tactilearena/tactilearena.github.io/docs/assets/figures/overview.jpg

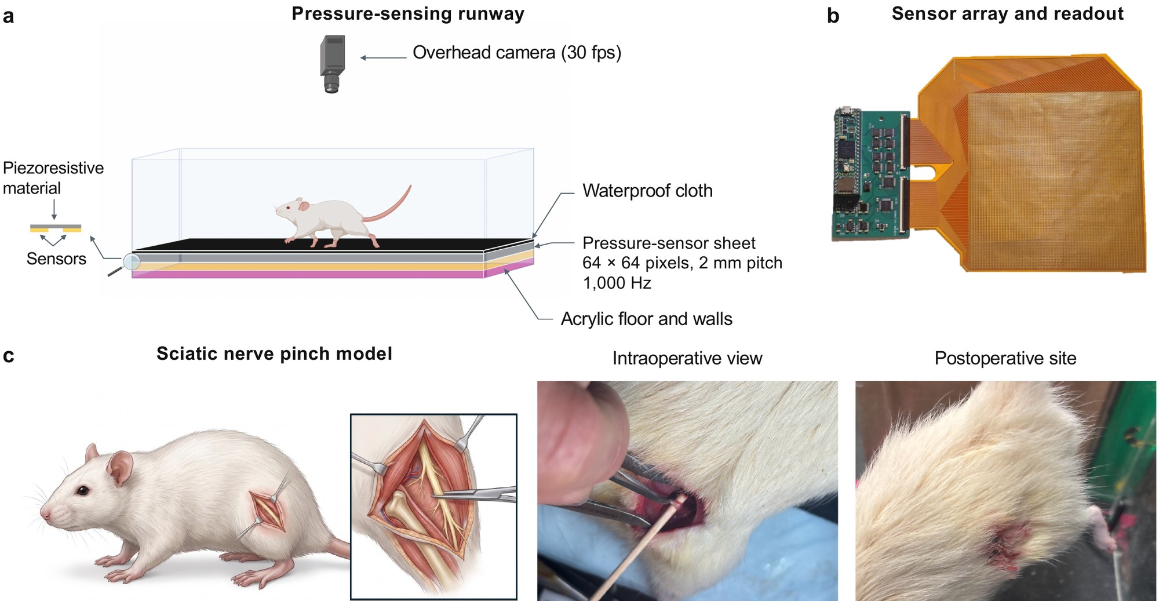
docs/assets/figures/overview.jpg
