tactilearena/tactilearena.github.io/docs/assets/loops/camera_floor.jpg

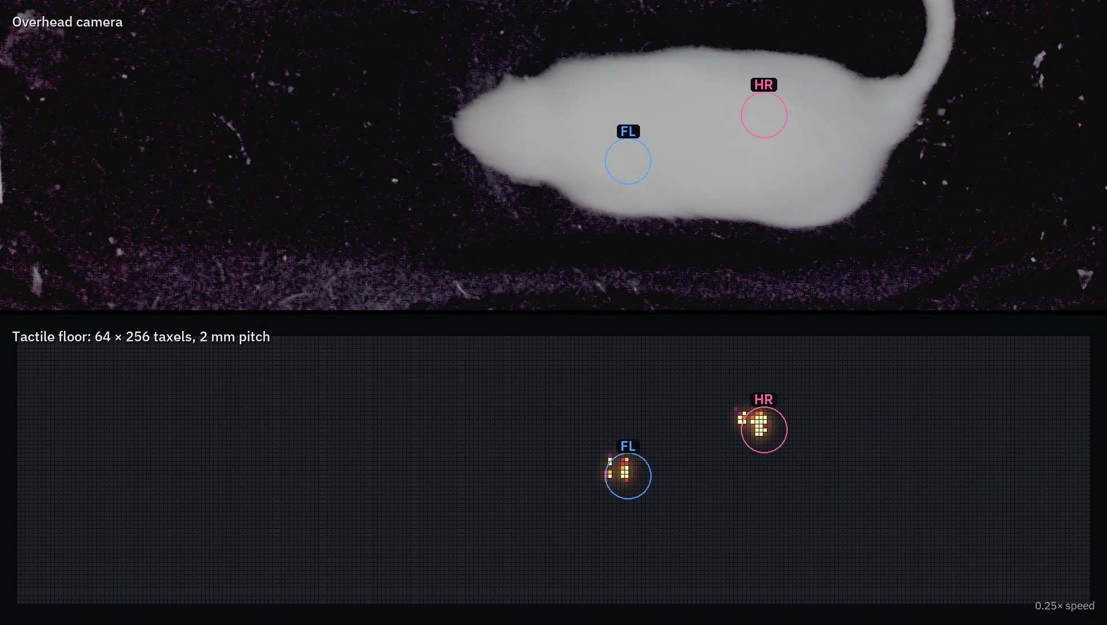
docs/assets/loops/camera_floor.jpg
