tactilearena/tactilearena.github.io/docs/assets/loops/hero.jpg

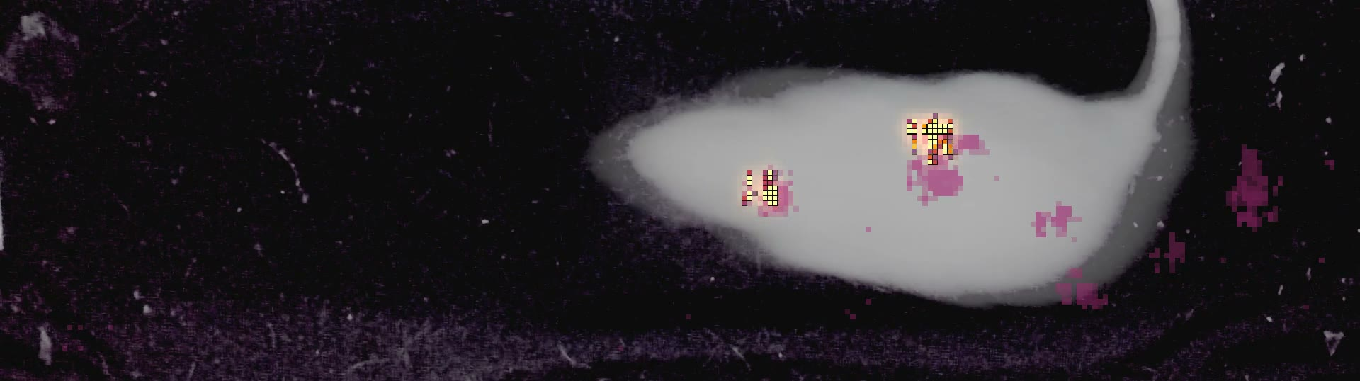
docs/assets/loops/hero.jpg
