tactilearena/tactilearena.github.io/docs/assets/loops/sampling.jpg

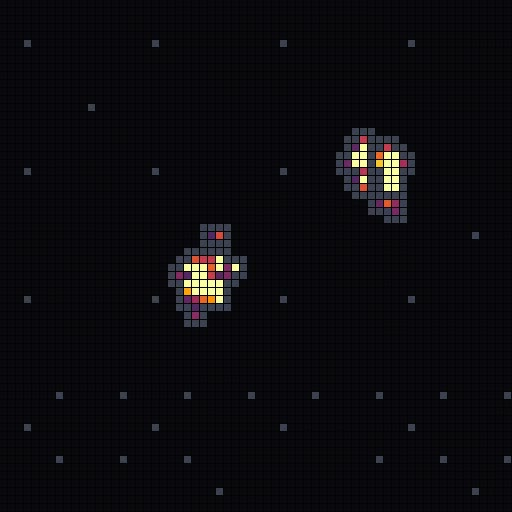
docs/assets/loops/sampling.jpg
