tactilearena/tactilearena.github.io/docs/assets/photos/readout_board.jpg

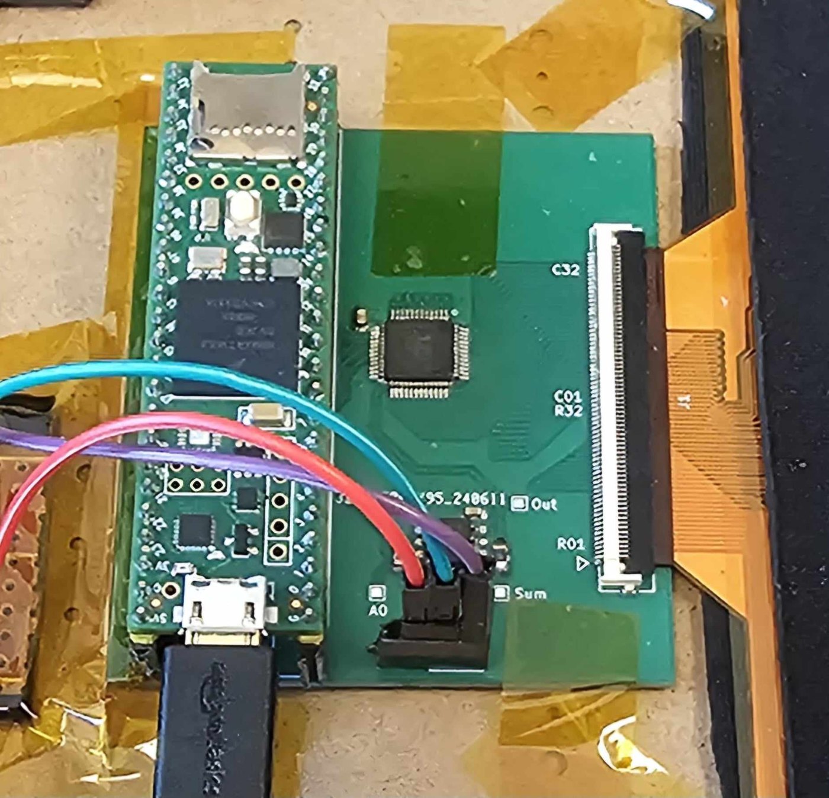
docs/assets/photos/readout_board.jpg
