tactilearena/tactilearena.github.io/docs/assets/photos/runway_rat.jpg

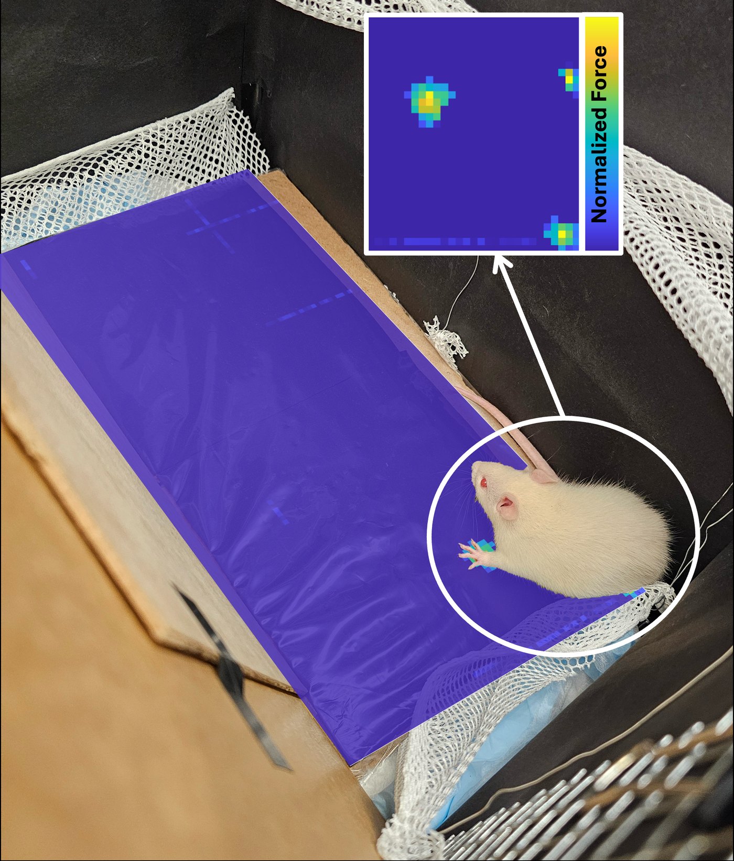
docs/assets/photos/runway_rat.jpg
