tactilearena/tactilearena.github.io/docs/assets/photos/runway_rat_raw.jpg

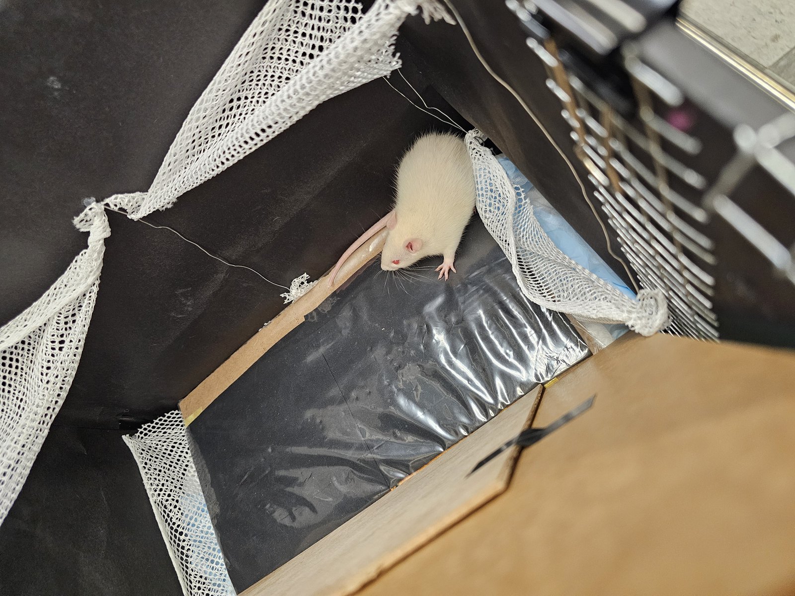
docs/assets/photos/runway_rat_raw.jpg
