tactilearena/tactilearena.github.io/docs/assets/photos/sensor_array.jpg

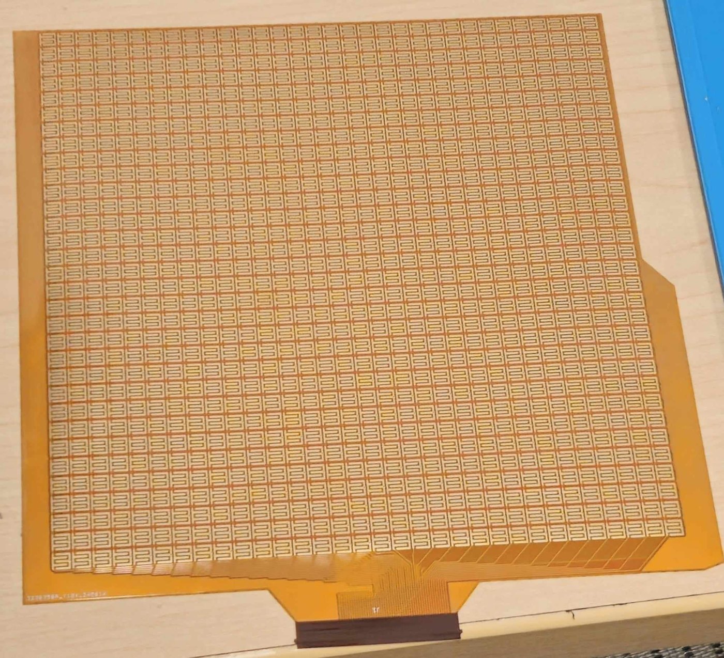
docs/assets/photos/sensor_array.jpg
