tactilearena/tactilearena.github.io/docs/assets/video/arena_bench.jpg

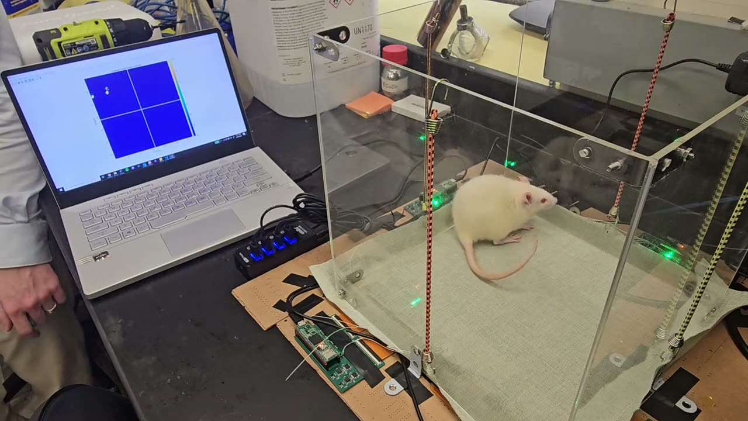
docs/assets/video/arena_bench.jpg
