tactilearena/tactilearena.github.io/docs/assets/video/arena_multi.jpg

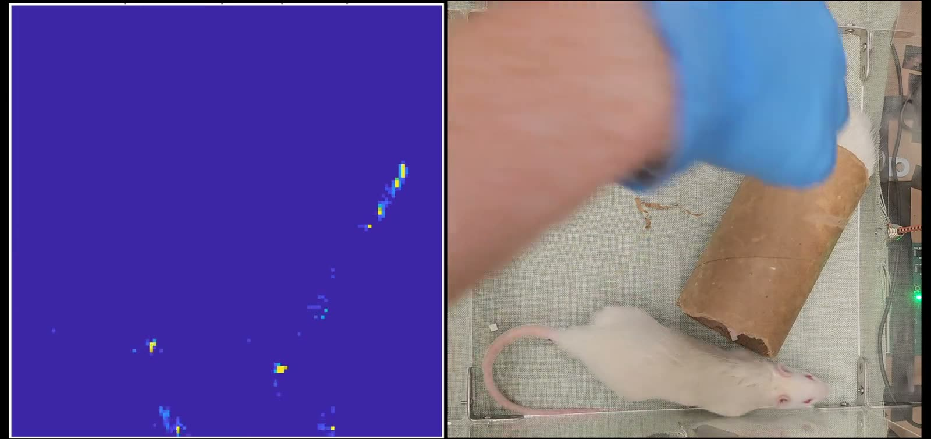
docs/assets/video/arena_multi.jpg
