tactilearena/tactilearena.github.io/docs/assets/video/overview.jpg

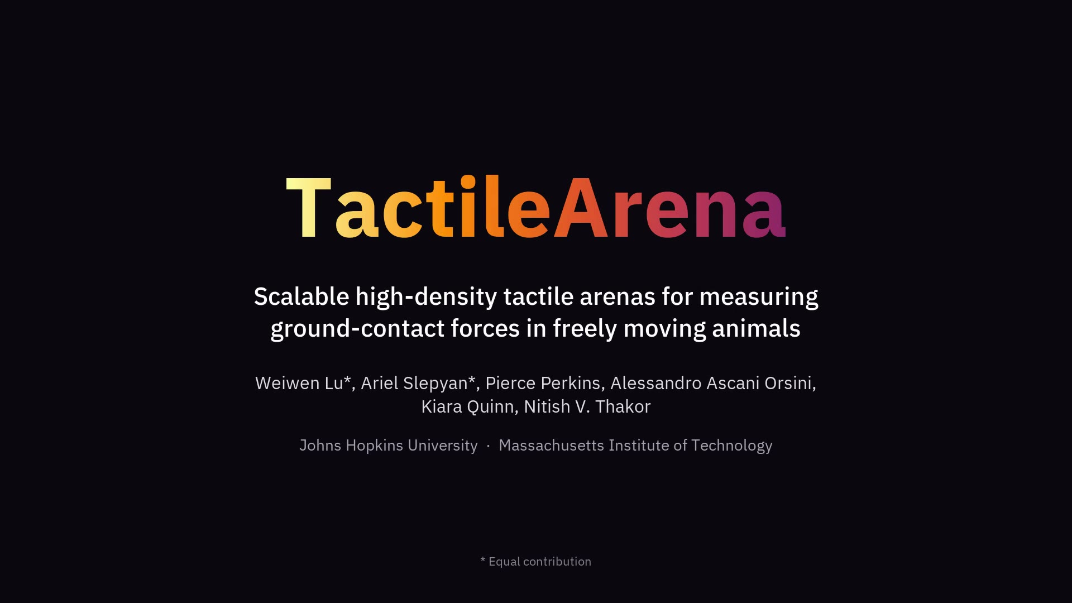
docs/assets/video/overview.jpg
