tactilearena/tactilearena.github.io/docs/assets/video/post-surgery.jpg

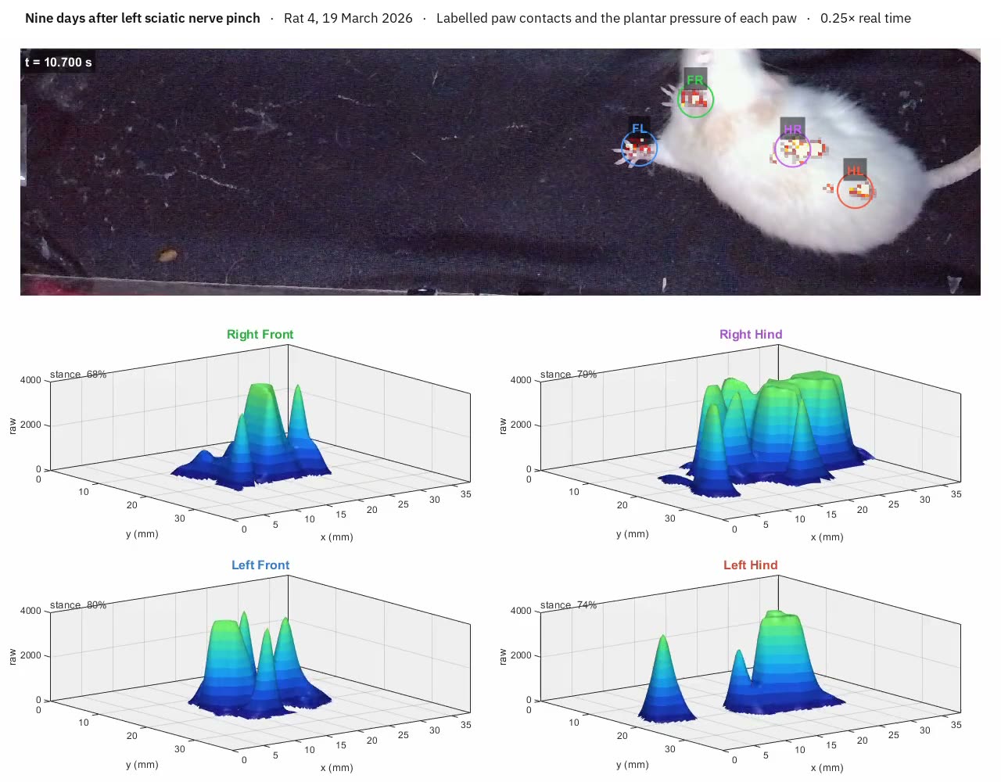
docs/assets/video/post-surgery.jpg
