tactilearena/tactilearena.github.io/docs/assets/video/pre-surgery.jpg

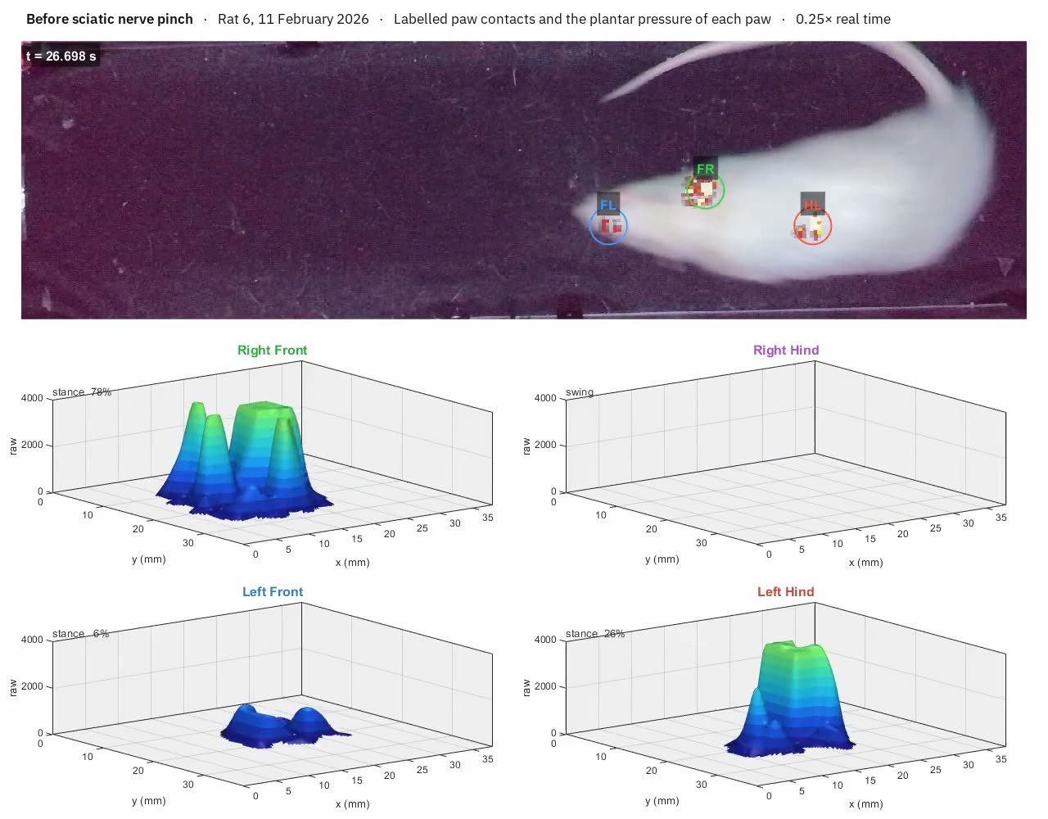
docs/assets/video/pre-surgery.jpg
