tactilearena/tactilearena.github.io/docs/assets/video/supp4_sampling.jpg

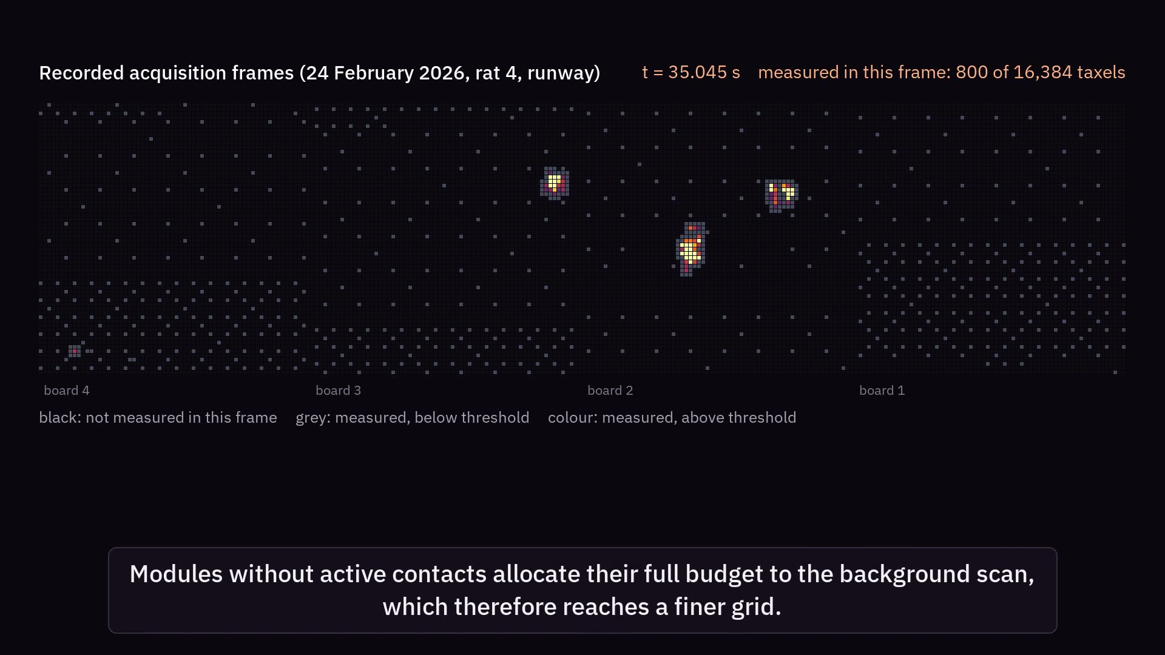
docs/assets/video/supp4_sampling.jpg
