tactilearena/tactilearena.github.io/docs/assets/video/supp5_arena.jpg

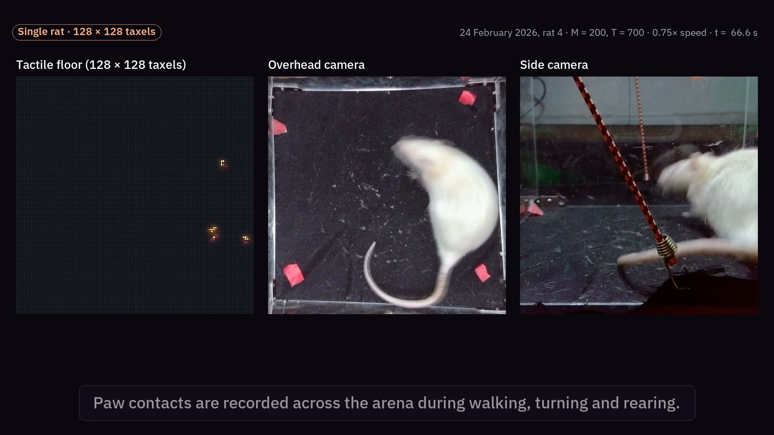
docs/assets/video/supp5_arena.jpg
