tactilearena/tactilearena.github.io/hardware/readout_64x64/bom.csv

Reference | Qty per board | Value | Description | Manufacturer part number | LCSC | Footprint | Fit | Notes
IC1-IC8 | 8 | 74LVC595APW | 8-bit shift register (drives the sensor rows) | 74LVC595APW | C426713 | SOP65P640X110-16N (TSSOP-16) | SMT
IC9 IC10 | 2 | ADG732BSUZ | 32:1 analog multiplexer (selects the sensor column) | ADG732BSUZ | C579103 | QFP50P900X900X120-48N (TQFP-48) | SMT | 0.5 mm pitch
IC11 IC14 | 2 | TLV9362 | Dual op-amp | TLV9362IDR | C4367884 | SOIC127P600X175-8N (SOIC-8) | SMT | The schematic's Manufacturer_Part_Number field still reads LM358BAIDR; the fitted part is TLV9362 (value and LCSC fields)
IC12 IC13 | 2 | AD7476ARTZ | 12-bit ADC (SPI) | AD7476ARTZ | C651070 | SOT95P280X145-6N (SOT-23-6) | SMT
J1 J2 | 2 | 5051107091 | 70-pin 0.5 mm FPC connector for the sensor's two tails | Molex 505110-7091 | C6393753 | 5051107091 | SMT | 0.5 mm pitch
U6 | 1 | LM2776 | Switched-capacitor voltage inverter | LM2776DBVR | C69527 | SOT-23-6 | SMT
VR1 VR2 | 2 | MCP41HV51-103E/ST | 10 kOhm digital potentiometer (gain; set by the firmware's digipot value) | MCP41HV51-103E/ST | C637062 | SOP65P640X120-14N (TSSOP-14) | SMT
U1 | 1 | Teensy 4.1 | Microcontroller board | Teensy 4.1 (PJRC/SparkFun DEV-16771) |  | Teensy41 | Hand | Marked DNP in the schematic; solder on 2 x 24 pin headers
C1-C22 | 22 | 0.1 uF | Ceramic capacitor |  | C28233 | 0805 | SMT
C31 C32 | 2 | 1 uF | Ceramic capacitor |  | C28323 | 0805 | SMT
C33 | 1 | 10 uF | Ceramic capacitor |  | C15850 | 0805 | SMT
D1 | 1 | LED | Indicator LED |  | C2297 | 0805 | SMT
R1 R2 | 2 | 10k | Resistor |  | C17414 | 0805 | SMT
R4 R5 R8 R9 | 4 | 1k | Resistor |  | C17513 | 0805 | SMT
R11 | 1 | 470 | Resistor |  | C17710 | 0805 | SMT
SW2 | 1 | SW_MEC_5E | Tactile switch (spare user button on Teensy pin 24; not used by the firmware) | SHOU HAN TS4538TP (4.5 x 4.5 x 3.8 mm) | C398052 | PTS647SN50SMTR2LFS | SMT | Fits the PTS647 footprint
R3 R7 | 2 | R | Not fitted |  |  | 0805 | DNP
TP1-TP9 | 9 | TestPoint | Test pads |  |  | TestPoint_Pad_1.0x1.0mm | DNP | Bare pads; nothing to fit
