tactilearena/tactilearena.github.io/docs/assets/video/assembly.jpg

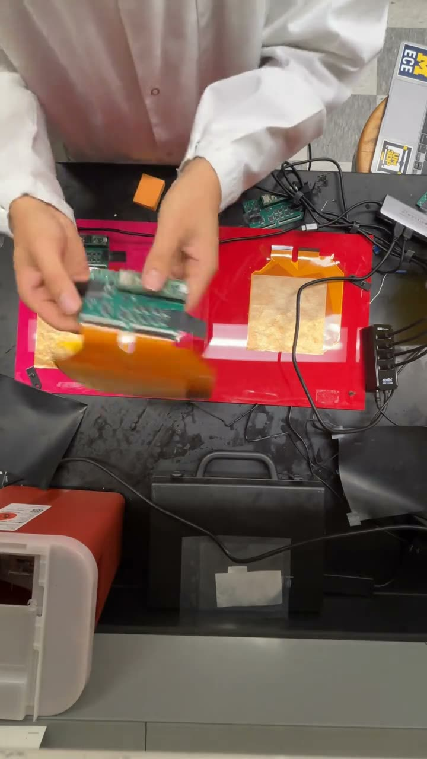
docs/assets/video/assembly.jpg
