tactilearena/tactilearena.github.io/hardware/readout_64x64/readout_64x64_regulated.kicad_pcb

## KiCad design hardware/readout_64x64/readout_64x64_regulated.kicad_pcb (2026-10-25)

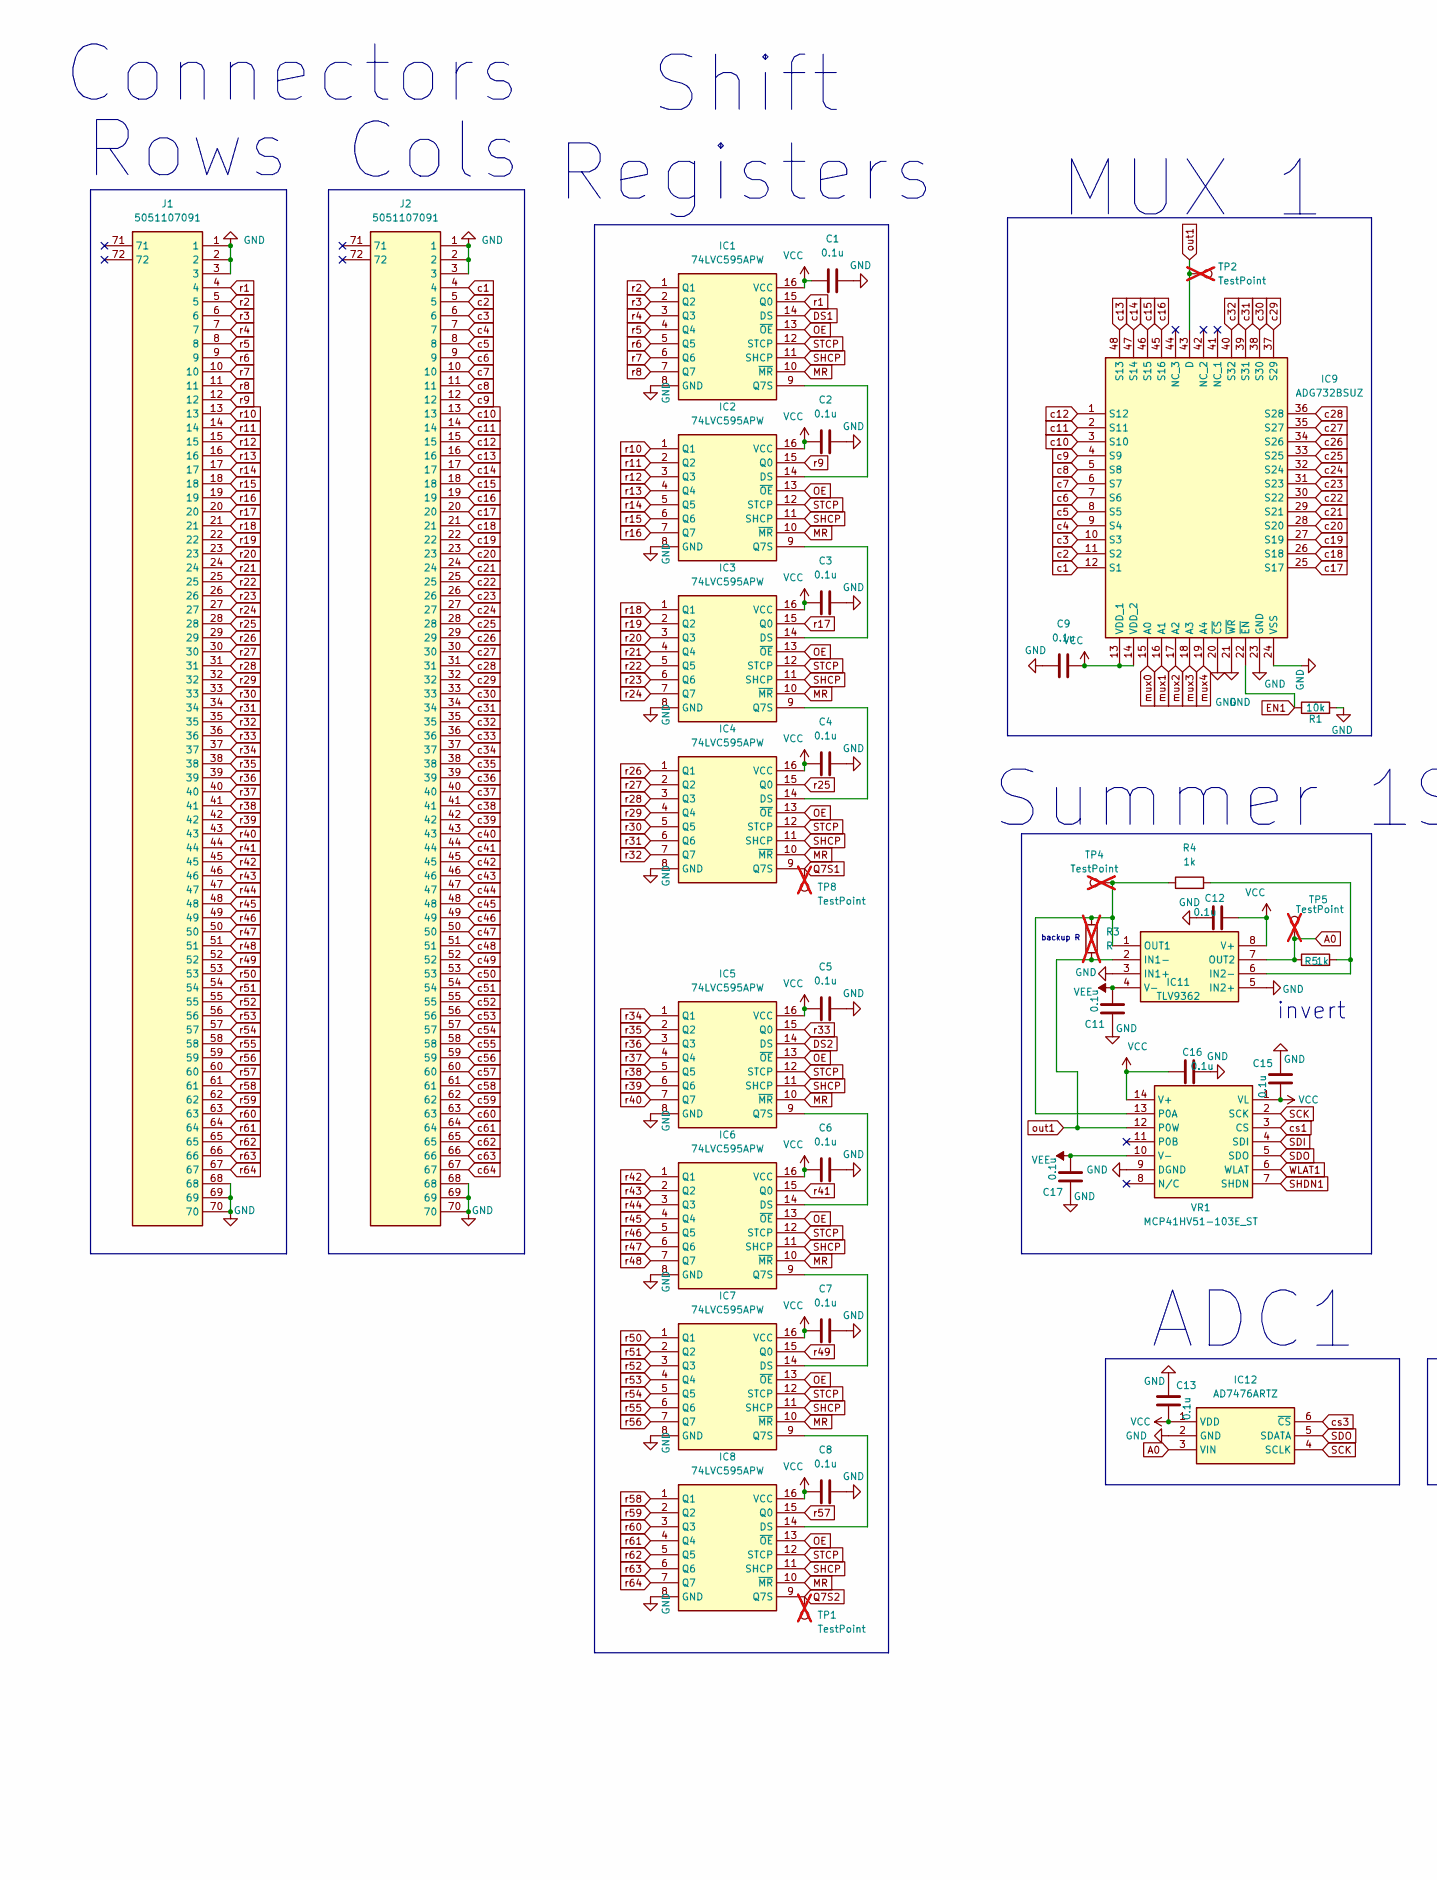
[picture p35: schematic readout_64x64_regulated.kicad_sch, part in row 1, column 1]

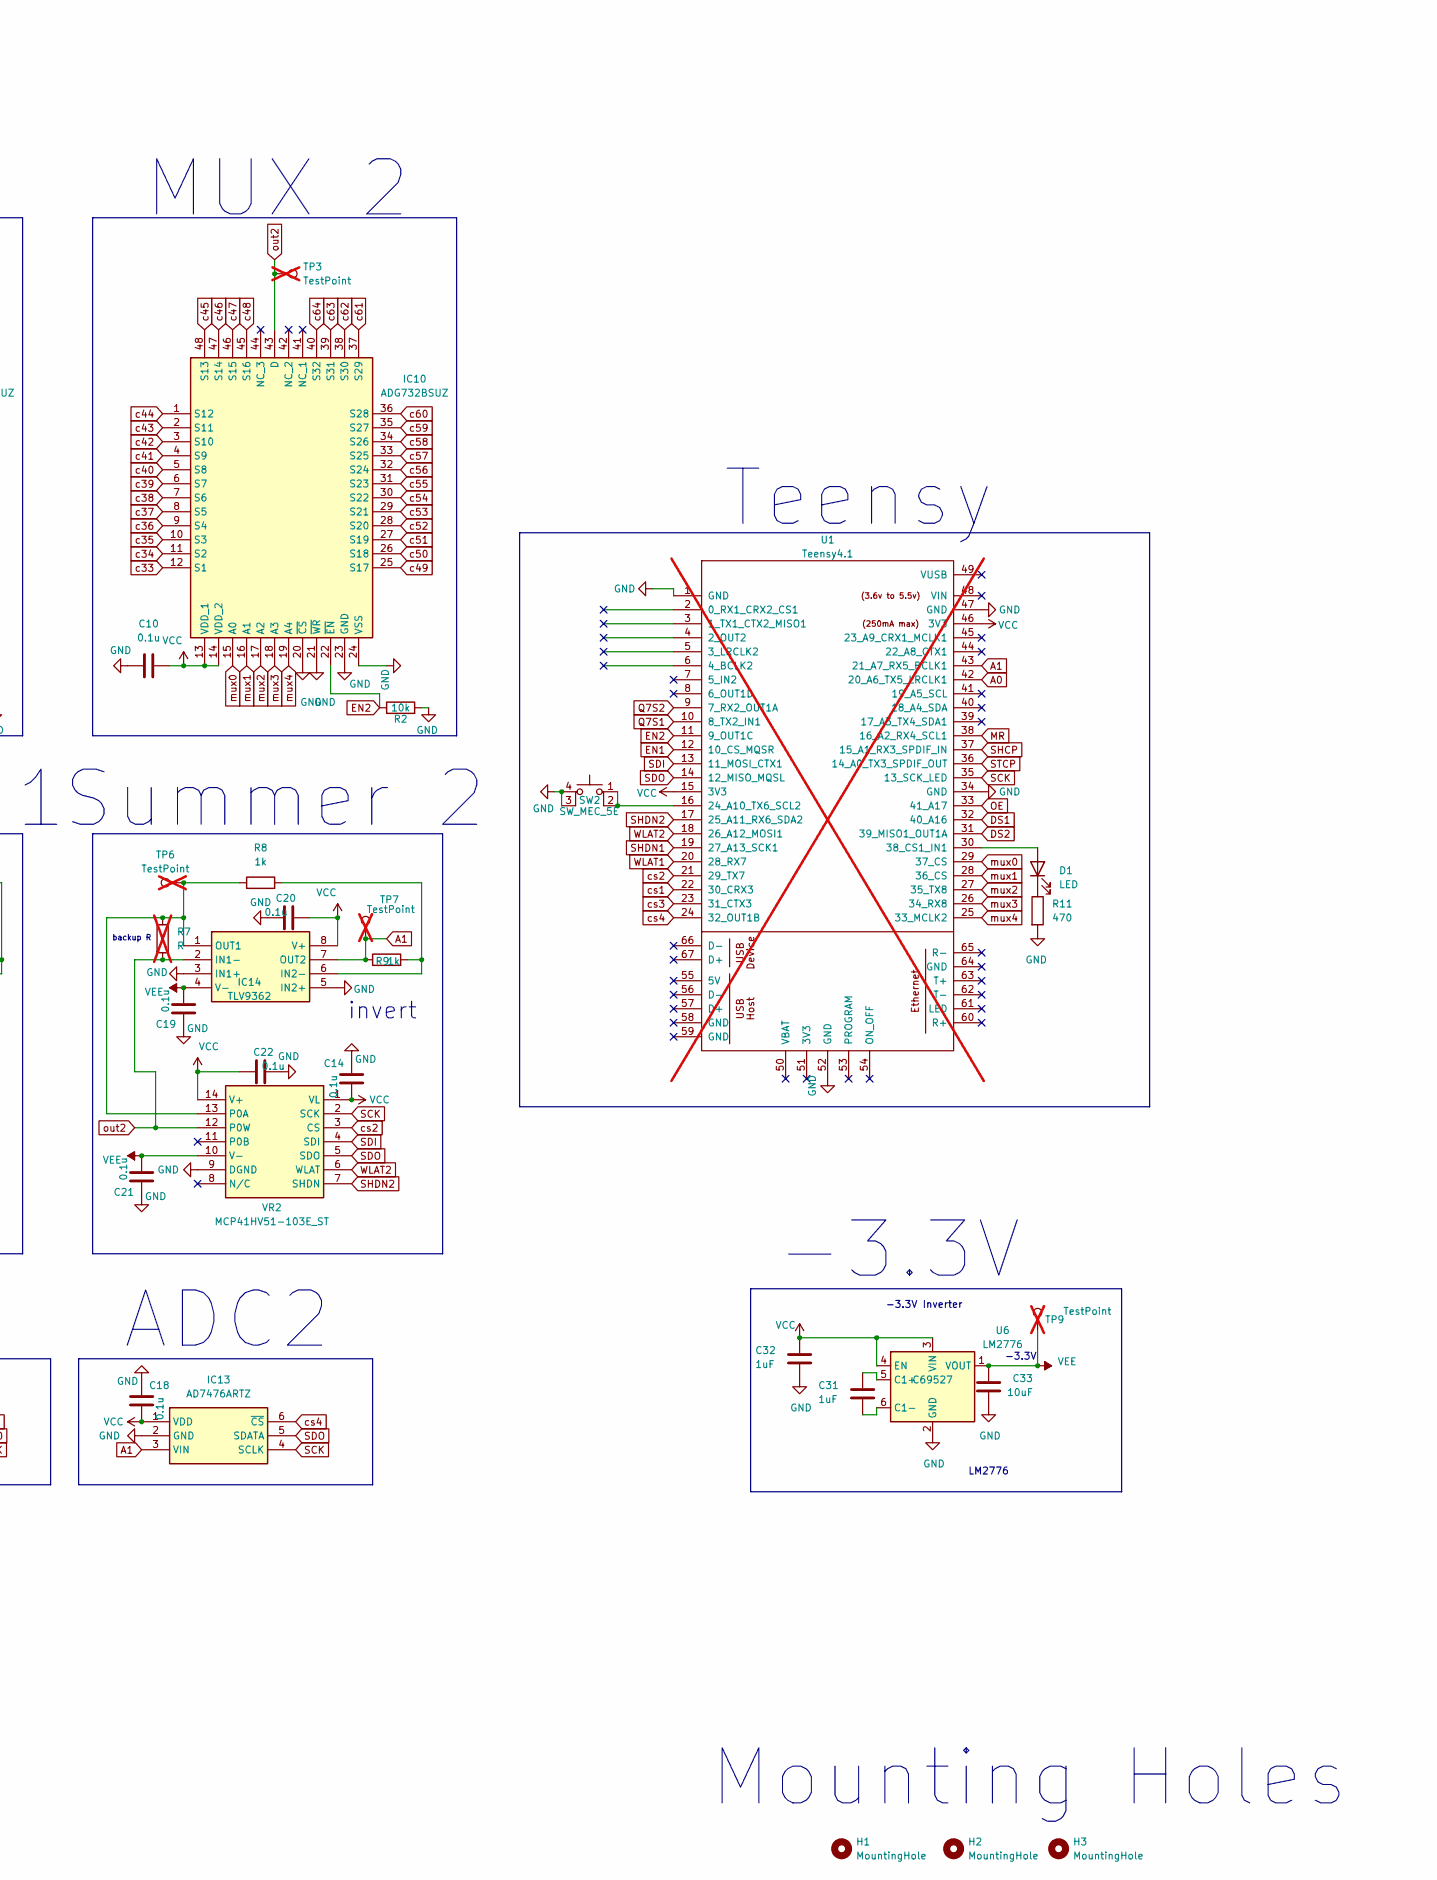
[picture p36: schematic readout_64x64_regulated.kicad_sch, part in row 1, column 2]

Parts:
C1, C2, C3, C4, C5, C6, C7, C8, C9, C10, C11, C12, C13, C14, C15, C16, C17, C18, C19, C20, C21, C22: 0.1u; C_0805_2012Metric; LCSC Part # C28233
C31, C32: 1uF; C_0805_2012Metric; LCSC Part # C28323
C33: 10uF; C_0805_2012Metric; LCSC Part # C15850
D1: LED; LED_0805_2012Metric; LCSC Part # C2297
H1, H2, H3: MountingHole; MountingHole_3.2mm_M3
IC1, IC2, IC3, IC4, IC5, IC6, IC7, IC8: 74LVC595APW; SOP65P640X110-16N; Manufacturer_Part_Number 74LVC595APW; Mouser Part Number 771-74LVC595APW
IC9, IC10: ADG732BSUZ; QFP50P900X900X120-48N; Manufacturer_Part_Number ADG732BSUZ; Mouser Part Number 584-ADG732BSUZ
IC11, IC14: TLV9362; SOIC127P600X175-8N; Manufacturer_Part_Number LM358BAIDR; Mouser Part Number 595-LM358BAIDR
IC12, IC13: AD7476ARTZ; SOT95P280X145-6N; Manufacturer_Part_Number AD7476ARTZ; LCSC Part # C651070
J1, J2: 5051107091; Manufacturer_Part_Number 5051107091; LCSC Part # C6393753
R1, R2: 10k; R_0805_2012Metric; LCSC Part # C17414
R3, R7: R; R_0805_2012Metric; not fitted
R4, R5, R8, R9: 1k; R_0805_2012Metric; LCSC Part # C17513
R11: 470; R_0805_2012Metric; LCSC Part # C17710
SW2: SW_MEC_5E; PTS647SN50SMTR2LFS; Manufacturer_Part_Number TS4538TP; LCSC Part # C398052
TP1, TP2, TP3, TP4, TP5, TP6, TP7, TP8, TP9: TestPoint; TestPoint_Pad_1.0x1.0mm; not fitted
U1: Teensy4.1; Teensy41; not fitted
U6: LM2776; SOT-23-6; LCSC Part # C69527
VR1, VR2: MCP41HV51-103E_ST; SOP65P640X120-14N; Manufacturer_Part_Number MCP41HV51-103E/ST; Mouser Part Number 579-MCP41HV51-103EST

Connections:
A0: IC11.7 (OUT2), IC12.3 (VIN), R5.1, TP5.1, U1.42 (20_A6_TX5_LRCLK1)
A1: IC13.3 (VIN), IC14.7 (OUT2), R9.1, TP7.1, U1.43 (21_A7_RX5_BCLK1)
DS1: IC1.14 (DS), U1.32 (40_A16)
DS2: IC5.14 (DS), U1.31 (39_MISO1_OUT1A)
EN1: IC9.22 (~EN), R1.1, U1.12 (10_CS_MQSR)
EN2: IC10.22 (~EN), R2.1, U1.11 (9_OUT1C)
GND: C1.2, C2.2, C3.2, C4.2, C5.2, C6.2, C7.2, C8.2, C9.2, C10.2, C11.2, C12.2, C13.2, C14.2, C15.2, C16.2, C17.2, C18.2, C19.2, C20.2, C21.2, C22.2, C32.2, C33.2, IC1.8 (GND), IC2.8 (GND), IC3.8 (GND), IC4.8 (GND), IC5.8 (GND), IC6.8 (GND), IC7.8 (GND), IC8.8 (GND), IC9.20 (~CS), IC9.21 (~WR), IC9.23 (GND), IC9.24 (VSS), IC10.20 (~CS), IC10.21 (~WR), IC10.23 (GND), IC10.24 (VSS), IC11.3 (IN1+), IC11.5 (IN2+), IC12.2 (GND), IC13.2 (GND), IC14.3 (IN1+), IC14.5 (IN2+), J1.1, J1.2, J1.3, J1.68, J1.69, J1.70, J2.1, J2.2, J2.3, J2.68, J2.69, J2.70, R1.2, R2.2, R11.2, SW2.3 (K), SW2.4 (A), U1.1 (GND), U1.34 (GND), U1.47 (GND), U1.52 (GND), U6.2 (GND), VR1.9 (DGND), VR2.9 (DGND)
MR: IC1.10 (~MR), IC2.10 (~MR), IC3.10 (~MR), IC4.10 (~MR), IC5.10 (~MR), IC6.10 (~MR), IC7.10 (~MR), IC8.10 (~MR), U1.38 (16_A2_RX4_SCL1)
unnamed: D1.2 (A), U1.30 (38_CS1_IN1)
unnamed: D1.1 (K), R11.1
unnamed: IC1.9 (Q7S), IC2.14 (DS)
unnamed: IC2.9 (Q7S), IC3.14 (DS)
unnamed: IC3.9 (Q7S), IC4.14 (DS)
unnamed: IC5.9 (Q7S), IC6.14 (DS)
unnamed: IC6.9 (Q7S), IC7.14 (DS)
unnamed: IC7.9 (Q7S), IC8.14 (DS)
unnamed: IC11.6 (IN2-), R4.2, R5.2
unnamed: IC11.1 (OUT1), R3.2, R4.1, TP4.1, VR1.13 (P0A)
unnamed: IC14.6 (IN2-), R8.2, R9.2
unnamed: IC14.1 (OUT1), R7.2, R8.1, TP6.1, VR2.13 (P0A)
unnamed: SW2.1, SW2.2, U1.16 (24_A10_TX6_SCL2)
unnamed: C31.1, U6.5 (C1+)
unnamed: C31.2, U6.6 (C1-)
OE: IC1.13 (~OE), IC2.13 (~OE), IC3.13 (~OE), IC4.13 (~OE), IC5.13 (~OE), IC6.13 (~OE), IC7.13 (~OE), IC8.13 (~OE), U1.33 (41_A17)
Q7S1: IC4.9 (Q7S), TP8.1, U1.10 (8_TX2_IN1)
Q7S2: IC8.9 (Q7S), TP1.1, U1.9 (7_RX2_OUT1A)
SCK: IC12.4 (SCLK), IC13.4 (SCLK), U1.35 (13_SCK_LED), VR1.2 (SCK), VR2.2 (SCK)
SDI: U1.13 (11_MOSI_CTX1), VR1.4 (SDI), VR2.4 (SDI)
SDO: IC12.5 (SDATA), IC13.5 (SDATA), U1.14 (12_MISO_MQSL), VR1.5 (SDO), VR2.5 (SDO)
SHCP: IC1.11 (SHCP), IC2.11 (SHCP), IC3.11 (SHCP), IC4.11 (SHCP), IC5.11 (SHCP), IC6.11 (SHCP), IC7.11 (SHCP), IC8.11 (SHCP), U1.37 (15_A1_RX3_SPDIF_IN)
SHDN1: U1.19 (27_A13_SCK1), VR1.7 (SHDN)
SHDN2: U1.17 (25_A11_RX6_SDA2), VR2.7 (SHDN)
STCP: IC1.12 (STCP), IC2.12 (STCP), IC3.12 (STCP), IC4.12 (STCP), IC5.12 (STCP), IC6.12 (STCP), IC7.12 (STCP), IC8.12 (STCP), U1.36 (14_A0_TX3_SPDIF_OUT)
VCC: C1.1, C2.1, C3.1, C4.1, C5.1, C6.1, C7.1, C8.1, C9.1, C10.1, C12.1, C13.1, C14.1, C15.1, C16.1, C18.1, C20.1, C22.1, C32.1, IC1.16 (VCC), IC2.16 (VCC), IC3.16 (VCC), IC4.16 (VCC), IC5.16 (VCC), IC6.16 (VCC), IC7.16 (VCC), IC8.16 (VCC), IC9.13 (VDD_1), IC9.14 (VDD_2), IC10.13 (VDD_1), IC10.14 (VDD_2), IC11.8 (V+), IC12.1 (VDD), IC13.1 (VDD), IC14.8 (V+), U1.15 (3V3), U1.46 (3V3), U6.3 (VIN), U6.4 (EN), VR1.1 (VL), VR1.14 (V+), VR2.1 (VL), VR2.14 (V+)
VEE: C11.1, C17.1, C19.1, C21.1, C33.1, IC11.4 (V-), IC14.4 (V-), TP9.1, U6.1 (VOUT), VR1.10 (V-), VR2.10 (V-)
WLAT1: U1.20 (28_RX7), VR1.6 (WLAT)
WLAT2: U1.18 (26_A12_MOSI1), VR2.6 (WLAT)
c1: IC9.12 (S1), J2.4
c2: IC9.11 (S2), J2.5
c3: IC9.10 (S3), J2.6
c4: IC9.9 (S4), J2.7
c5: IC9.8 (S5), J2.8
c6: IC9.7 (S6), J2.9
c7: IC9.6 (S7), J2.10
c8: IC9.5 (S8), J2.11
c9: IC9.4 (S9), J2.12
c10: IC9.3 (S10), J2.13
c11: IC9.2 (S11), J2.14
c12: IC9.1 (S12), J2.15
c13: IC9.48 (S13), J2.16
c14: IC9.47 (S14), J2.17
c15: IC9.46 (S15), J2.18
c16: IC9.45 (S16), J2.19
c17: IC9.25 (S17), J2.20
c18: IC9.26 (S18), J2.21
c19: IC9.27 (S19), J2.22
c20: IC9.28 (S20), J2.23
c21: IC9.29 (S21), J2.24
c22: IC9.30 (S22), J2.25
c23: IC9.31 (S23), J2.26
c24: IC9.32 (S24), J2.27
c25: IC9.33 (S25), J2.28
c26: IC9.34 (S26), J2.29
c27: IC9.35 (S27), J2.30
c28: IC9.36 (S28), J2.31
c29: IC9.37 (S29), J2.32
c30: IC9.38 (S30), J2.33
c31: IC9.39 (S31), J2.34
c32: IC9.40 (S32), J2.35
c33: IC10.12 (S1), J2.36
c34: IC10.11 (S2), J2.37
c35: IC10.10 (S3), J2.38
c36: IC10.9 (S4), J2.39
c37: IC10.8 (S5), J2.40
c38: IC10.7 (S6), J2.41
c39: IC10.6 (S7), J2.42
c40: IC10.5 (S8), J2.43
c41: IC10.4 (S9), J2.44
c42: IC10.3 (S10), J2.45
c43: IC10.2 (S11), J2.46
c44: IC10.1 (S12), J2.47
c45: IC10.48 (S13), J2.48
c46: IC10.47 (S14), J2.49
c47: IC10.46 (S15), J2.50
c48: IC10.45 (S16), J2.51
c49: IC10.25 (S17), J2.52
c50: IC10.26 (S18), J2.53
c51: IC10.27 (S19), J2.54
c52: IC10.28 (S20), J2.55
c53: IC10.29 (S21), J2.56
c54: IC10.30 (S22), J2.57
c55: IC10.31 (S23), J2.58
c56: IC10.32 (S24), J2.59
c57: IC10.33 (S25), J2.60
c58: IC10.34 (S26), J2.61
c59: IC10.35 (S27), J2.62
c60: IC10.36 (S28), J2.63
c61: IC10.37 (S29), J2.64
c62: IC10.38 (S30), J2.65
c63: IC10.39 (S31), J2.66
c64: IC10.40 (S32), J2.67
cs1: U1.22 (30_CRX3), VR1.3 (CS)
cs2: U1.21 (29_TX7), VR2.3 (CS)
cs3: IC12.6 (~CS), U1.23 (31_CTX3)
cs4: IC13.6 (~CS), U1.24 (32_OUT1B)
mux0: IC9.15 (A0), IC10.15 (A0), U1.29 (37_CS)
mux1: IC9.16 (A1), IC10.16 (A1), U1.28 (36_CS)
mux2: IC9.17 (A2), IC10.17 (A2), U1.27 (35_TX8)
mux3: IC9.18 (A3), IC10.18 (A3), U1.26 (34_RX8)
mux4: IC9.19 (A4), IC10.19 (A4), U1.25 (33_MCLK2)
out1: IC9.43 (D), IC11.2 (IN1-), R3.1, TP2.1, VR1.12 (P0W)
out2: IC10.43 (D), IC14.2 (IN1-), R7.1, TP3.1, VR2.12 (P0W)
r1: IC1.15 (Q0), J1.4
r2: IC1.1 (Q1), J1.5
r3: IC1.2 (Q2), J1.6
r4: IC1.3 (Q3), J1.7
r5: IC1.4 (Q4), J1.8
r6: IC1.5 (Q5), J1.9
r7: IC1.6 (Q6), J1.10
r8: IC1.7 (Q7), J1.11
r9: IC2.15 (Q0), J1.12
r10: IC2.1 (Q1), J1.13
r11: IC2.2 (Q2), J1.14
r12: IC2.3 (Q3), J1.15
r13: IC2.4 (Q4), J1.16
r14: IC2.5 (Q5), J1.17
r15: IC2.6 (Q6), J1.18
r16: IC2.7 (Q7), J1.19
r17: IC3.15 (Q0), J1.20
r18: IC3.1 (Q1), J1.21
r19: IC3.2 (Q2), J1.22
r20: IC3.3 (Q3), J1.23
r21: IC3.4 (Q4), J1.24
r22: IC3.5 (Q5), J1.25
r23: IC3.6 (Q6), J1.26
r24: IC3.7 (Q7), J1.27
r25: IC4.15 (Q0), J1.28
r26: IC4.1 (Q1), J1.29
r27: IC4.2 (Q2), J1.30
r28: IC4.3 (Q3), J1.31
r29: IC4.4 (Q4), J1.32
r30: IC4.5 (Q5), J1.33
r31: IC4.6 (Q6), J1.34
r32: IC4.7 (Q7), J1.35
r33: IC5.15 (Q0), J1.36
r34: IC5.1 (Q1), J1.37
r35: IC5.2 (Q2), J1.38
r36: IC5.3 (Q3), J1.39
r37: IC5.4 (Q4), J1.40
r38: IC5.5 (Q5), J1.41
r39: IC5.6 (Q6), J1.42
r40: IC5.7 (Q7), J1.43
r41: IC6.15 (Q0), J1.44
r42: IC6.1 (Q1), J1.45
r43: IC6.2 (Q2), J1.46
r44: IC6.3 (Q3), J1.47
r45: IC6.4 (Q4), J1.48
r46: IC6.5 (Q5), J1.49
r47: IC6.6 (Q6), J1.50
r48: IC6.7 (Q7), J1.51
r49: IC7.15 (Q0), J1.52
r50: IC7.1 (Q1), J1.53
r51: IC7.2 (Q2), J1.54
r52: IC7.3 (Q3), J1.55
r53: IC7.4 (Q4), J1.56
r54: IC7.5 (Q5), J1.57
r55: IC7.6 (Q6), J1.58
r56: IC7.7 (Q7), J1.59
r57: IC8.15 (Q0), J1.60
r58: IC8.1 (Q1), J1.61
r59: IC8.2 (Q2), J1.62
r60: IC8.3 (Q3), J1.63
r61: IC8.4 (Q4), J1.64
r62: IC8.5 (Q5), J1.65
r63: IC8.6 (Q6), J1.66
r64: IC8.7 (Q7), J1.67

Notes on the sheet:
invert
Shift Registers
backup R
Connectors
Rows
Teensy
Summer 1
-3.3V
ADC1
Cols
ADC2
MUX 2
-3.3V Inverter
LM2776
Summer 2
MUX 1
Mounting Holes

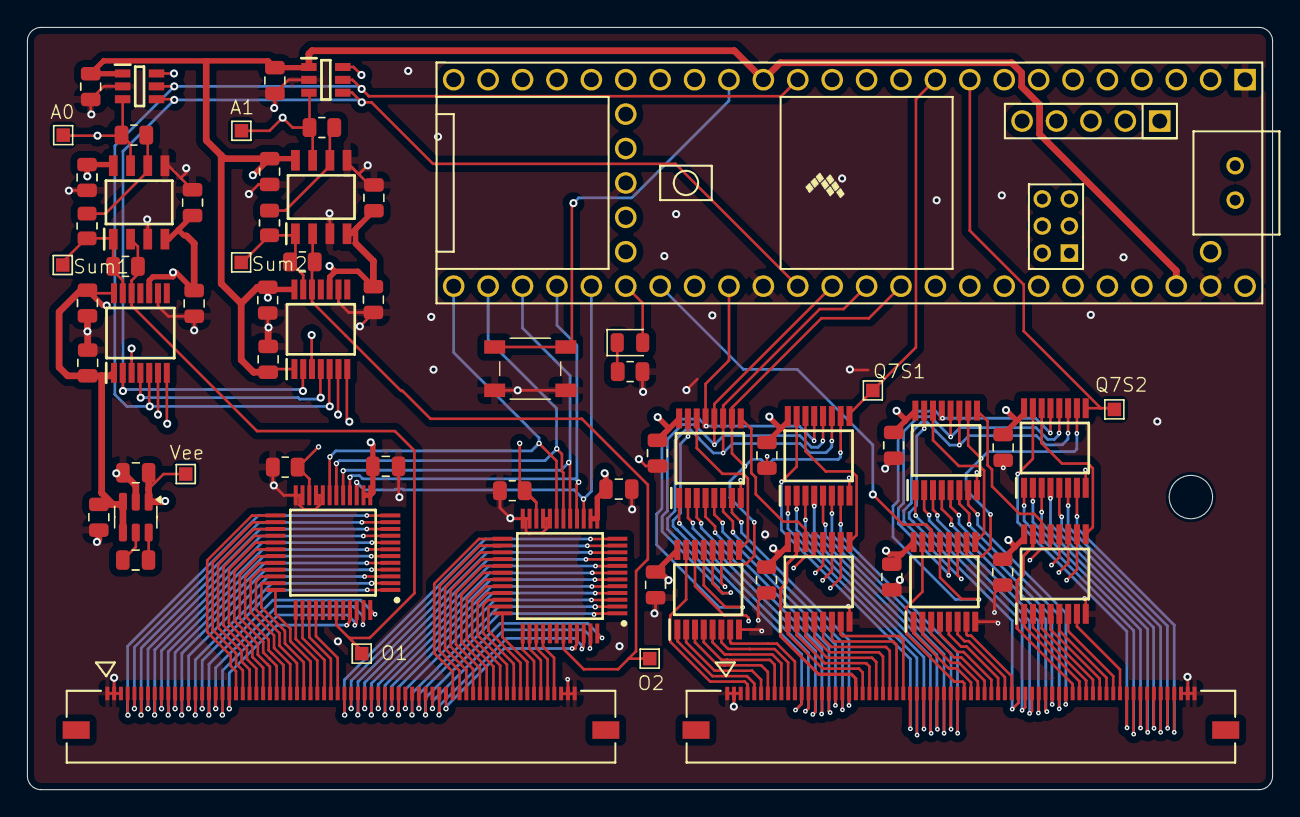
[picture p37: board readout_64x64_regulated.kicad_pcb from above]

Board: 4 copper layers, 91.9 x 56.3 mm, 66 parts (0 on the bottom side), 176 nets.
