tactilearena/tactilearena.github.io/(commit log)

2026-10-10 Add runway gait analysis pipeline, demo and acquisition code
    - pipeline/: s1 prepare recordings, s2 tail-base CNN + contact detector,
    s3 COP walking bouts, s4 paw labeling (+ labeled video), s5 gram calibration
    - tailbase/: tail-base CNN (annotate/train/predict)
    - acquisition/: recording + live-view scripts and board firmware
    - demo/: run_demo.m with expected outputs for one recording
    - data/: platform template, per-board calibration, tail-base checkpoint
    - README with setup, usage and per-stage output formats
2026-10-16 TactileArena: project website, media tools and README
    - MkDocs Material site in docs/ (home, how it works, results, build, software, data, paper),
    with a hero loop and camera-vs-floor loop rendered from the 2026-02-24 rat 4 recording,
    an in-browser port of the readout firmware's adaptive sampling loop, and a frame-by-frame
    replay of the real packets
    - site_tools/: scripts that rebuild every website video and data file from a raw recording
    (frame reconstruction as in the pipeline: latest packet per board, boards 4-3-2-1)
    - Pages workflow (skips while the repository is private), CITATION.cff, CC BY 4.0 for site content
    - README: TactileArena name, current title, website links; history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
2026-10-16 How it works: use photos of the 64x64 hardware
    The bare-sensor and readout-board photos were of the 32x32 design (one tail, one connector).
    Replace them with the assembled runway (NER 2025 poster) and the 64x64 readout board cropped from
    the module photo used in the manuscript's overview figure.
2026-10-16 Fix videos on Results and Build; show equal contribution on Paper
    - Raw-HTML video/poster/track paths on sub-pages now start with ../ (MkDocs does not rewrite
    links inside raw HTML, so assets/... resolved under /results/ and /build/ and 404'd)
    - Paper: asterisks in the author list were parsed as Markdown emphasis; use &ast; and bold the
    co-first authors
2026-10-16 Hardware: KiCad sources, fabrication Gerbers and BOM for the 64x64 sensor and readout board
    - hardware/sensor_64x64: flex-PCB sensor layout + the Gerbers it was made from
    - hardware/readout_64x64: schematic, layout, Gerbers and a per-board BOM (bom.csv); the Teensy 4.1
    and the two MCP41HV51 digital potentiometers are marked DNP in the schematic (not in the board-house
    order) and are fitted by hand
    - Gerber copper layers and outlines checked against the current KiCad layouts (identical)
    - CERN-OHL-P-2.0 for hardware/ (LICENSE-hardware)
    - Build page: design-files section; cost updated to ~US$550 per runway (~US$140 per module) now
    that the digital potentiometers are included
2026-10-17 Supplementary videos 1-5: legends, website section and the scripts that render 4 and 5
    - supplementary/README.md: legends and links to the full-quality files on the
    supplementary-videos-v1 release
    - Paper page: Supplementary videos section (web copies + full-quality downloads)
    - site_tools/make_supp_sampling.py (Video 4: adaptive sampling, simulation + recorded packets)
    - site_tools/make_supp_square.py + ta_square.py (Video 5: 2x2 open arena with the study's settings,
    stall-free stretch, overhead camera rotated 180 deg as in the pipeline; three-rat development clip)
    - assembly video: background-music audio track removed (licence unknown)
2026-10-21 Professional-register revision of the website, overview video and Supplementary Videos 4-5
    Incorporates Weiwen Lu's review:
    - conventional gait measures described with reference to CatWalk-type platforms
    - adaptive sampling described in terms of the configurable pressure threshold
    - 'load distribution among the four paws'
    - Supplementary Fig. S3 caption notes the slower early and more abrupt late anterior-posterior COP progression
    Formal headings, captions and labels throughout; Paper page shows the manuscript abstract.
2026-10-21 Align with the latest manuscript: restyled Fig. 5 and updated results
    - Fig. 5 from the current Overleaf source (Weiwen Lu's restyled version); home-page panel d re-cropped
    - Updated values: loading ratio -0.59/-0.54, duty-factor ratio -0.33/-0.30, injured hindpaw -27%/-18%,
    contralateral hindpaw +22%/+23%, hindlimb imbalance (35-40% vs 50% of hindlimb load), new morphology statistics
    - Supplementary Fig. S3 caption follows the manuscript (910 footprints; lift-off shifts; slower initial
    progression and sharper shift before lift-off)
    - Paper page abstract and limitations follow the manuscript; overview video re-rendered
    - How it works: runway schematic only (no longer a manuscript figure)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
2026-10-21 Fix missing home-page video; formal wording in hardware README
    - The camera/floor loop was excluded by the repository's camera_*.mp4 ignore rule (meant for raw
    recordings) and never reached the site; renamed to floor_and_camera.mp4
    - hardware/README.md: formal register
2026-10-21 Polish for submission: supplementary videos, site layout, documentation
    Supplementary videos
    - Video 1: the source's informal burned-in captions are covered by formal step captions
    (site_tools/clean_assembly_video.py)
    - Videos 2-3: the pipeline's file-name title line is replaced by a descriptive title, and the diagnostic
    '(label row N)' annotation is removed from the paw panels (site_tools/clean_annotated_videos.py)
    - Video 4: panels labelled by board ID (4-1, left to right), as in the data description
    - Video 5 and the overview: the three-rat clip is cropped below its own panel titles and labelled like the
    rest of the video; overview captions are complete sentences; overview poster is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
2026-10-21 Code comments: describe current behaviour only
    Comment-only edits in the pipeline, acquisition scripts and firmware: development history, references to
    files that are not in the repository and commented-out code removed; comments that contradicted the code
    corrected (thresholds, budgets, rotations, camera count, body-axis source). The detector header notes that
    s2_detect_contacts.m sets the values used in the paper. Two figure-window titles renamed. Executable lines are
    unchanged; supplementary/README points to site_tools for the video scripts.
2026-10-21 Rename development-style file names
    - acquisition/firmware/readout_64x64/readout_64x64.ino (was binary_sampling_64x64_6MHz_BigBuffer_Vis_ID; folder
    and sketch renamed together, as the Arduino IDE requires; contents unchanged)
    - pipeline/peak_seed_contact_detector.m (was segmentation_peak_seed_refined_runway.m; s2 runs it through
    cfg.detector_script, updated in gait_config.m; no other code refers to the file name)
    - s3 actions review_auto/export_auto (were review_new/export_new) and use_auto_detector_bouts
    - References updated in README.md, acquisition/firmware/README.md, site_tools/ta_square.py and sampling.js
2026-10-21 Cameras: overhead and side (as in the Methods); analysis scripts available on request
    - The runway recordings use one overhead camera and one side camera (the side view assists manual paw
    labelling); README, record_runway.py comments and the Build, How it works and Software pages said 'overhead
    cameras'
    - README and Software page: scripts for the gait metrics and statistical analyses are available from the
    corresponding authors upon request, consistent with the manuscript
2026-10-22 Consistency with the final manuscript
    - Supplementary Video 1 shows the film, not the waterproof cloth: Paper page, legends and Build page
    (steps 2-4 and 6 are shown) corrected; overview caption updated
    - Frame rate stated as approximately 1 kHz (median interval about 1 ms), as in the manuscript
    - Fig. 2 caption and the walking-window description follow the manuscript's wording
    - Calibration README: formal wording of the usage notes
2026-10-22 Overview video: assembly segment without overlapping captions; caption states what is shown
    - The segment uses the part of Supplementary Video 1 between its own captions (connection of the sensor
    tails to the readout boards) and the caption describes that step
    - runway_rat_raw.jpg restored (used by the overview's runway scene) and kept in make_site_assets.py
2026-10-25 Preprint posted on bioRxiv (doi:10.64898/2026.10.22.760735)
    - Home: 'Preprint' button and preprint citation; Paper page: preprint link and citation
    - README, CITATION.cff (preferred-citation), supplementary legends and release notes cite the preprint
2026-10-25 Readout board: MCP41HV51 potentiometers assembled by the board house; JLCPCB assembly files
    - VR1, VR2 (MCP41HV51-103E/ST): no longer do-not-populate; LCSC C637062 added (schematic and layout)
    - Layout synced to the schematic: TP9 do-not-populate, IC11/IC14 value TLV9362
    - Gerbers, JLCPCB BOM and placement files re-exported with the Fabrication Toolkit plugin (KiCad 10)
    - Copper and nets unchanged; ERC/DRC results unchanged from before the edit
2026-10-25 Readout board: SW2 tactile switch from JLCPCB's assembly library (TS4538TP, C398052)
    Fits the existing PTS647 footprint (same 4.5 x 4.5 mm body and terminals); only the part number fields change.
    Assembly files re-exported; ERC/DRC unchanged.
2026-10-25 Hardware README: remove dated assembly-stock statement
2026-10-25 Build guide: update assembly cost for board-assembled potentiometers; note sourcing of out-of-stock parts
